espway/espway/schematic/espway.png

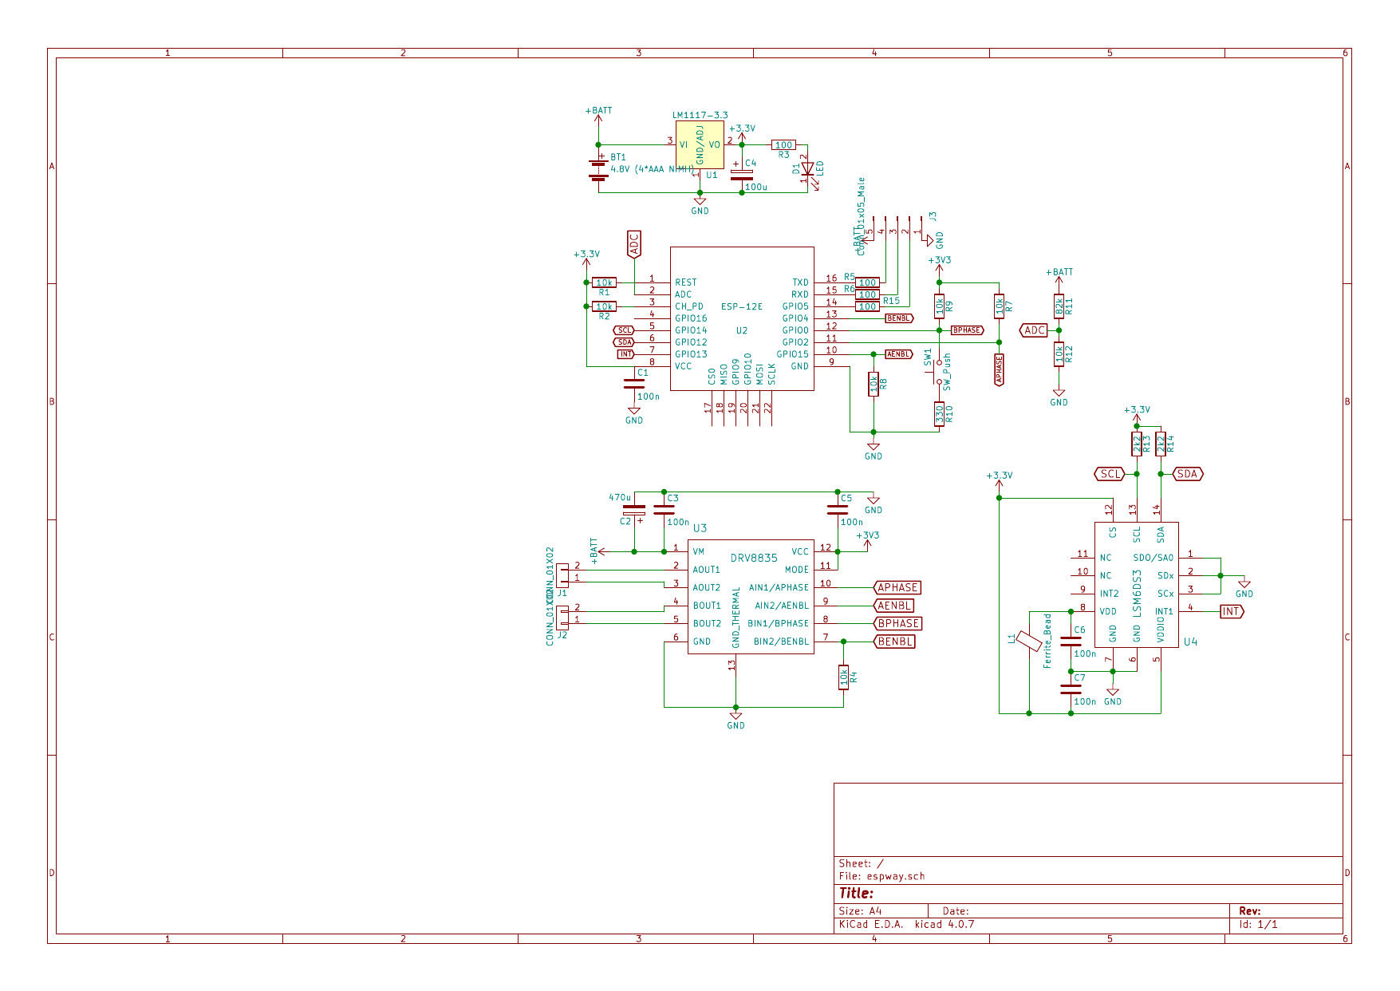
schematic/espway.png
