espway/espway/schematic/espway.pdf

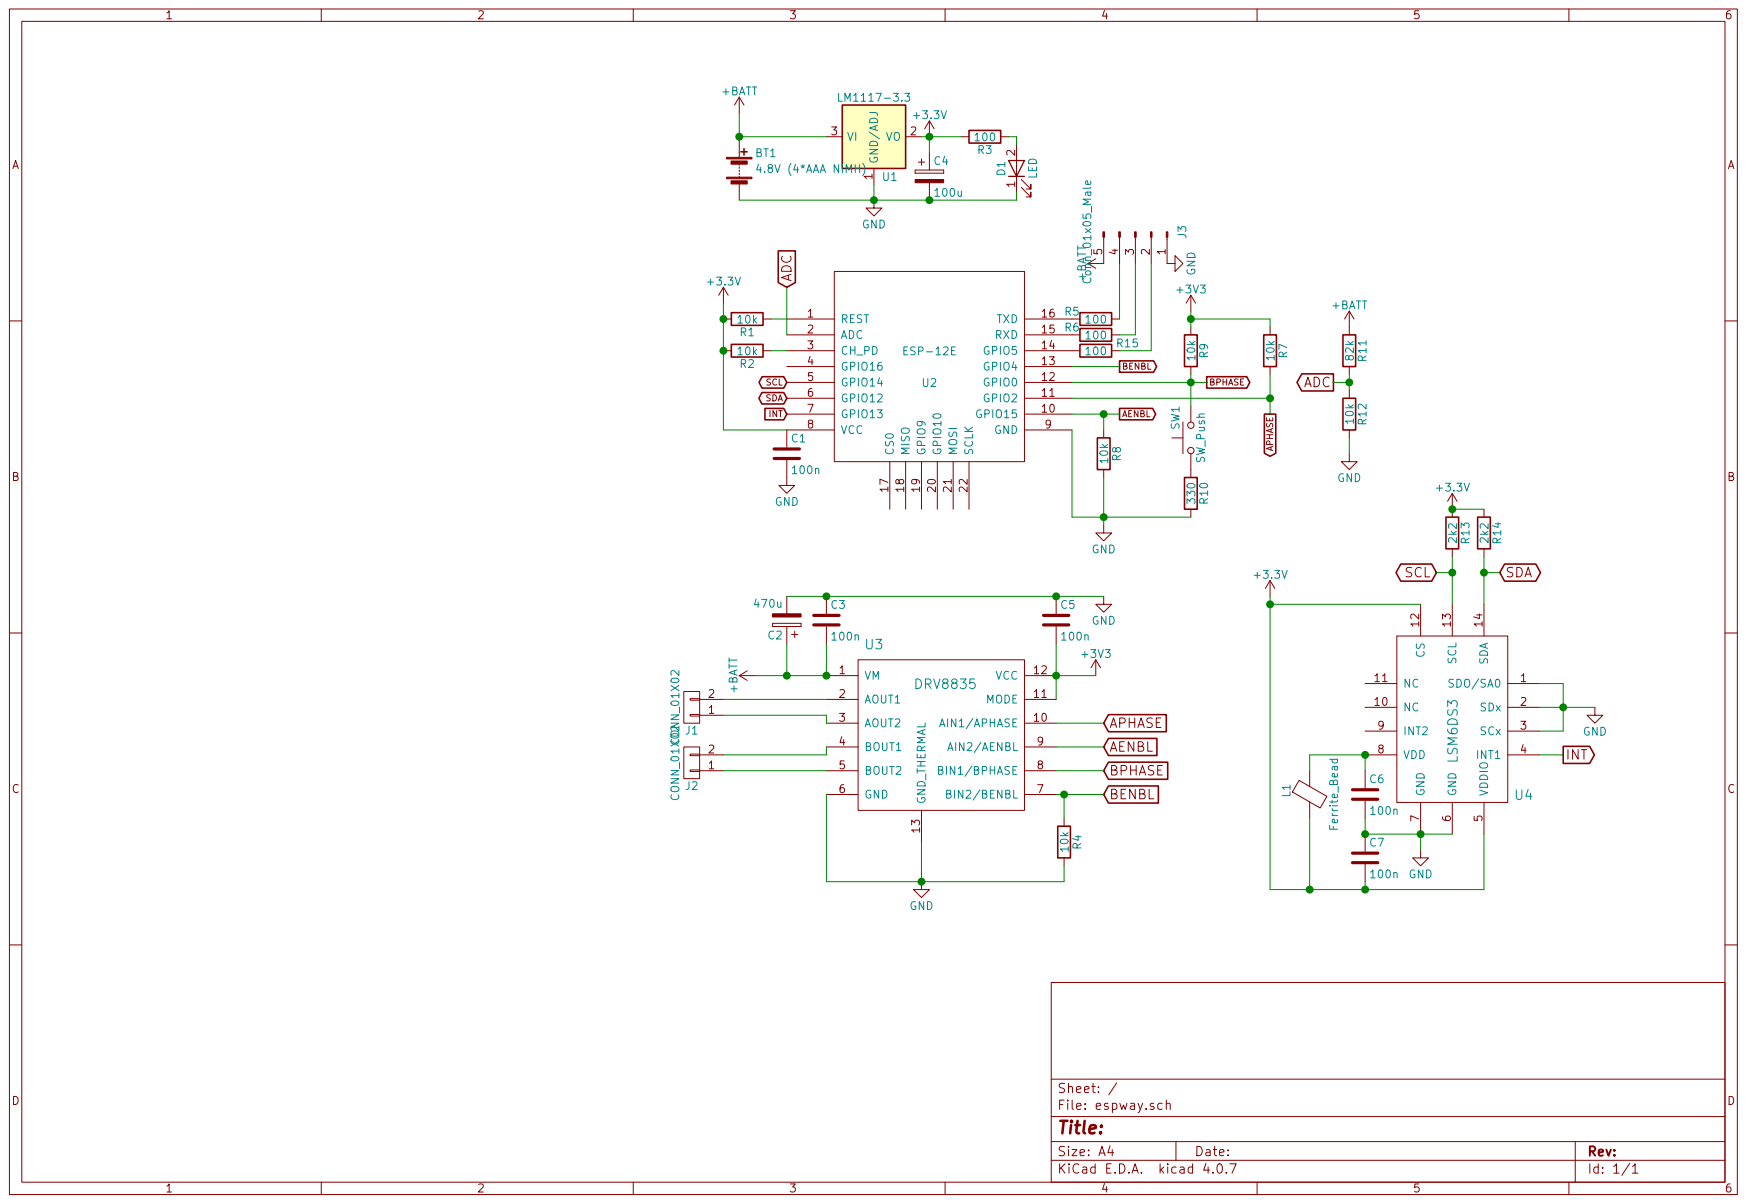
[picture p2: page 1]
