espway/espway/schematic-old/espway.pdf

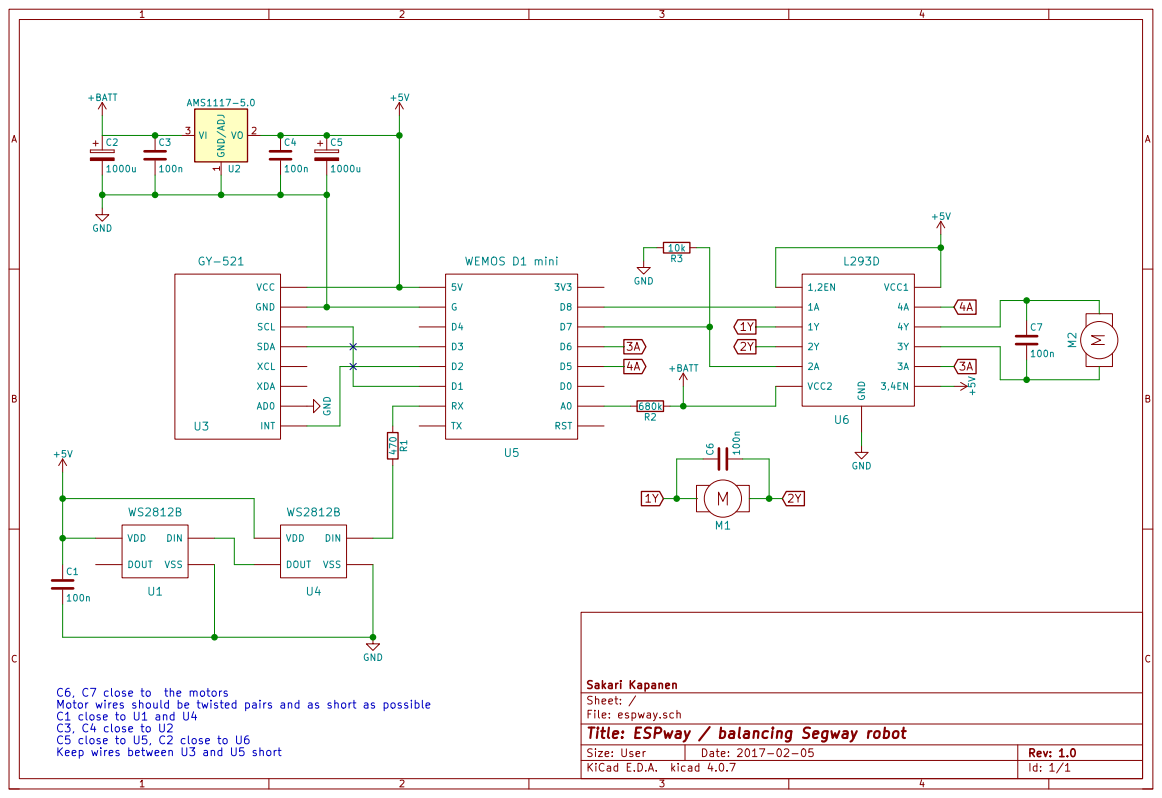
[picture p3: page 1]

File: espway.sch Sheet: / Sakari Kapanen

C6, C7 close to the motors
Motor wires should be twisted pairs and as short as possible
C1 close to U1 and U4
C3, C4 close to U2
C5 close to U5, C2 close to U6
Keep wires between U3 and U5 short

Id: 1/1 Title: ESPway / balancing Segway robot
