espway/espway/src/espway_config.c

/*
 * Firmware for a segway-style robot using ESP8266.
 * Copyright (C) 2017  Sakari Kapanen
 *
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
 * You should have received a copy of the GNU Lesser General Public License
 * along with this program.  If not, see <http://www.gnu.org/licenses/>.
 */

#include <sysparam.h>
#include <stdio.h>

#include "espway.h"

espway_config my_config;

const static espway_config DEFAULT_CONFIG = {
  .pid_coeffs_arr = {
    { FLT_TO_Q16(ANGLE_KP), FLT_TO_Q16(ANGLE_KI), FLT_TO_Q16(ANGLE_KD) },
    { FLT_TO_Q16(VEL_KP), FLT_TO_Q16(VEL_KI), FLT_TO_Q16(VEL_KD) }
  },
  .gyro_offsets = { GYRO_X_OFFSET, GYRO_Y_OFFSET, GYRO_Z_OFFSET }
};

void pretty_print_config(void)
{
  xSemaphoreTake(pid_mutex, portMAX_DELAY);
  printf(
      "\n\nESPway current config:\n\n"
      "#define ANGLE_KP %d\n"
      "#define ANGLE_KI %d\n"
      "#define ANGLE_KD %d\n"
      "#define VEL_KP %d\n"
      "#define VEL_KI %d\n"
      "#define VEL_KD %d\n"
      "#define GYRO_X_OFFSET %d\n"
      "#define GYRO_Y_OFFSET %d\n"
      "#define GYRO_Z_OFFSET %d\n"
      "\n\n",
      my_config.pid_coeffs_arr[ANGLE].p,
      my_config.pid_coeffs_arr[ANGLE].i,
      my_config.pid_coeffs_arr[ANGLE].d,
      my_config.pid_coeffs_arr[VEL].p,
      my_config.pid_coeffs_arr[VEL].i,
      my_config.pid_coeffs_arr[VEL].d,
      my_config.gyro_offsets[0],
      my_config.gyro_offsets[1],
      my_config.gyro_offsets[2]
  );
  xSemaphoreGive(pid_mutex);
}

void load_hardcoded_config(void)
{
  my_config = DEFAULT_CONFIG;
}

void load_config(void)
{
  xSemaphoreTake(pid_mutex, portMAX_DELAY);
  load_hardcoded_config();
  sysparam_get_data_static("ANGLE_PID", (uint8_t *)&my_config.pid_coeffs_arr[ANGLE],
      sizeof(pid_coeffs), NULL, NULL);
  sysparam_get_data_static("VEL_PID", (uint8_t *)&my_config.pid_coeffs_arr[VEL],
      sizeof(pid_coeffs), NULL, NULL);
  sysparam_get_data_static("GYRO_OFFSETS", (uint8_t *)&my_config.gyro_offsets,
      3 * sizeof(int16_t), NULL, NULL);
  xSemaphoreGive(pid_mutex);
}

void apply_config_params(void)
{
  xSemaphoreTake(pid_mutex, portMAX_DELAY);
  pid_initialize(&my_config.pid_coeffs_arr[ANGLE],
      FLT_TO_Q16(SAMPLE_TIME),
      -Q16_ONE, Q16_ONE, false, &pid_settings_arr[ANGLE]);
  pid_initialize(&my_config.pid_coeffs_arr[VEL],
      FLT_TO_Q16(SAMPLE_TIME),
      STABLE_ANGLE - FALL_LIMIT, STABLE_ANGLE + FALL_LIMIT, true,
      &pid_settings_arr[VEL]);
  xSemaphoreGive(pid_mutex);
}

bool save_flash_config(void)
{
  bool success = true;

  xSemaphoreTake(pid_mutex, portMAX_DELAY);
  success = sysparam_set_data("ANGLE_PID", (uint8_t *)&my_config.pid_coeffs_arr[ANGLE],
      sizeof(pid_coeffs), true) == SYSPARAM_OK;
  if (success) success = sysparam_set_data("VEL_PID", (uint8_t *)&my_config.pid_coeffs_arr[VEL], sizeof(pid_coeffs), true) == SYSPARAM_OK;
  xSemaphoreGive(pid_mutex);
  if (success) success = sysparam_set_data("GYRO_OFFSETS", (uint8_t *)&my_config.gyro_offsets, 3 * sizeof(int16_t), true) == SYSPARAM_OK;

  return success;
}

bool clear_flash_config(void)
{
  uint32_t base_addr, num_sectors;
  return sysparam_get_info(&base_addr, &num_sectors) == SYSPARAM_OK &&
    sysparam_create_area(base_addr, num_sectors, true) == SYSPARAM_OK &&
    sysparam_init(base_addr, 0) == SYSPARAM_OK;
}

void update_pid_controller(pid_controller_index idx, q16 p, q16 i, q16 d)
{
  if (idx > 2) return;
  xSemaphoreTake(pid_mutex, portMAX_DELAY);
  pid_coeffs *p_coeffs = &my_config.pid_coeffs_arr[idx];
  p_coeffs->p = p;
  p_coeffs->i = i;
  p_coeffs->d = d;
  pid_update_params(p_coeffs, &pid_settings_arr[idx]);

  xSemaphoreGive(pid_mutex);
}
