espway/espway/src/espway.h

#pragma once

#include <FreeRTOS.h>
#include <semphr.h>
#include <task.h>

#include "lib/pid.h"
#include "lib/imu_hal.h"
#include "lib/vector3d.h"
#include "espway_config.h"

#define SAMPLE_TIME IMU_SAMPLE_TIME

typedef enum {
  STEERING = 0,

  REQ_ORIENTATION = 1,
  RES_ORIENTATION = 2,

  BATTERY = 3,
  BATTERY_CUTOFF = 4,

  REQ_SET_PID_PARAMS = 5,
  RES_SET_PID_PARAMS_ACK = 6,
  REQ_GET_PID_PARAMS = 7,
  RES_PID_PARAMS = 8,

  REQ_SET_GYRO_OFFSETS = 9,
  RES_SET_GYRO_OFFSETS_FAILURE = 10,
  RES_SET_GYRO_OFFSETS_SUCCESS = 11,

  REQ_SAVE_CONFIG = 12,
  RES_SAVE_CONFIG_FAILURE = 13,
  RES_SAVE_CONFIG_SUCCESS = 14,

  REQ_CLEAR_CONFIG = 15,
  RES_CLEAR_CONFIG_FAILURE = 16,
  RES_CLEAR_CONFIG_SUCCESS = 17,

  REQ_LOAD_FLASH_CONFIG = 18,
  RES_LOAD_FLASH_CONFIG_DONE = 19,

  REQ_ENABLE_MOTORS = 20,
  REQ_DISABLE_MOTORS = 21
} ws_msg_t;

typedef struct {
  pid_coeffs pid_coeffs_arr[2];
  int16_t gyro_offsets[3];
} espway_config;

typedef enum {
  ANGLE = 0,
  VEL
} pid_controller_index;

typedef struct {
  q16 sin_pitch;
  q16 sin_roll;
} orientation;

typedef enum { STABILIZING_ORIENTATION, RUNNING, FALLEN, WOUND_UP } state;

extern espway_config my_config;

extern SemaphoreHandle_t pid_mutex;
extern pidsettings pid_settings_arr[2];

void pretty_print_config();
void apply_config_params();
bool save_flash_config();
bool clear_flash_config();
void load_config();
void load_hardcoded_config();
void update_pid_controller(pid_controller_index idx, q16 p, q16 i, q16 d);

void httpd_task(void *pvParameters);

void battery_cutoff();

state get_state();
void set_steering(q16 new_target_speed, q16 new_turning_bias);
orientation get_orientation();

void maze_solver_task(void *pvParameters);
