espway/espway/src/fsdata_custom.c

#include "lwip/apps/fs.h"
#include "lwip/def.h"


#define file_NULL (struct fsdata_file *) NULL


#ifndef FS_FILE_FLAGS_HEADER_INCLUDED
#define FS_FILE_FLAGS_HEADER_INCLUDED 1
#endif
#ifndef FS_FILE_FLAGS_HEADER_PERSISTENT
#define FS_FILE_FLAGS_HEADER_PERSISTENT 0
#endif
/* FSDATA_FILE_ALIGNMENT: 0=off, 1=by variable, 2=by include */
#ifndef FSDATA_FILE_ALIGNMENT
#define FSDATA_FILE_ALIGNMENT 0
#endif
#ifndef FSDATA_ALIGN_PRE
#define FSDATA_ALIGN_PRE
#endif
#ifndef FSDATA_ALIGN_POST
#define FSDATA_ALIGN_POST
#endif
#if FSDATA_FILE_ALIGNMENT==2
#include "fsdata_alignment.h"
#endif
#if FSDATA_FILE_ALIGNMENT==1
static const unsigned int dummy_align__index_bundle_js = 0;
#endif
static const unsigned char FSDATA_ALIGN_PRE data__index_bundle_js[] FSDATA_ALIGN_POST = {
/* /index.bundle.js (17 chars) */
0x2f,0x69,0x6e,0x64,0x65,0x78,0x2e,0x62,0x75,0x6e,0x64,0x6c,0x65,0x2e,0x6a,0x73,
0x00,0x00,0x00,0x00,

/* HTTP header */
/* "HTTP/1.0 200 OK
" (17 bytes) */
0x48,0x54,0x54,0x50,0x2f,0x31,0x2e,0x30,0x20,0x32,0x30,0x30,0x20,0x4f,0x4b,0x0d,
0x0a,
/* "Server: lwIP/2.0.3d (http://savannah.nongnu.org/projects/lwip)
" (64 bytes) */
0x53,0x65,0x72,0x76,0x65,0x72,0x3a,0x20,0x6c,0x77,0x49,0x50,0x2f,0x32,0x2e,0x30,
0x2e,0x33,0x64,0x20,0x28,0x68,0x74,0x74,0x70,0x3a,0x2f,0x2f,0x73,0x61,0x76,0x61,
0x6e,0x6e,0x61,0x68,0x2e,0x6e,0x6f,0x6e,0x67,0x6e,0x75,0x2e,0x6f,0x72,0x67,0x2f,
0x70,0x72,0x6f,0x6a,0x65,0x63,0x74,0x73,0x2f,0x6c,0x77,0x69,0x70,0x29,0x0d,0x0a,

/* "Content-Length: 7773
" (18+ bytes) */
0x43,0x6f,0x6e,0x74,0x65,0x6e,0x74,0x2d,0x4c,0x65,0x6e,0x67,0x74,0x68,0x3a,0x20,
0x37,0x37,0x37,0x33,0x0d,0x0a,
/* "Content-Type: application/javascript

" (40 bytes) */
0x43,0x6f,0x6e,0x74,0x65,0x6e,0x74,0x2d,0x54,0x79,0x70,0x65,0x3a,0x20,0x61,0x70,
0x70,0x6c,0x69,0x63,0x61,0x74,0x69,0x6f,0x6e,0x2f,0x6a,0x61,0x76,0x61,0x73,0x63,
0x72,0x69,0x70,0x74,0x0d,0x0a,0x0d,0x0a,
/* raw file data (7773 bytes) */
0x21,0x66,0x75,0x6e,0x63,0x74,0x69,0x6f,0x6e,0x28,0x65,0x29,0x7b,0x66,0x75,0x6e,
0x63,0x74,0x69,0x6f,0x6e,0x20,0x74,0x28,0x72,0x29,0x7b,0x69,0x66,0x28,0x6e,0x5b,
0x72,0x5d,0x29,0x72,0x65,0x74,0x75,0x72,0x6e,0x20,0x6e,0x5b,0x72,0x5d,0x2e,0x65,
0x78,0x70,0x6f,0x72,0x74,0x73,0x3b,0x76,0x61,0x72,0x20,0x69,0x3d,0x6e,0x5b,0x72,
0x5d,0x3d,0x7b,0x69,0x3a,0x72,0x2c,0x6c,0x3a,0x21,0x31,0x2c,0x65,0x78,0x70,0x6f,
0x72,0x74,0x73,0x3a,0x7b,0x7d,0x7d,0x3b,0x72,0x65,0x74,0x75,0x72,0x6e,0x20,0x65,
0x5b,0x72,0x5d,0x2e,0x63,0x61,0x6c,0x6c,0x28,0x69,0x2e,0x65,0x78,0x70,0x6f,0x72,
0x74,0x73,0x2c,0x69,0x2c,0x69,0x2e,0x65,0x78,0x70,0x6f,0x72,0x74,0x73,0x2c,0x74,
0x29,0x2c,0x69,0x2e,0x6c,0x3d,0x21,0x30,0x2c,0x69,0x2e,0x65,0x78,0x70,0x6f,0x72,
0x74,0x73,0x7d,0x76,0x61,0x72,0x20,0x6e,0x3d,0x7b,0x7d,0x3b,0x72,0x65,0x74,0x75,
0x72,0x6e,0x20,0x74,0x2e,0x6d,0x3d,0x65,0x2c,0x74,0x2e,0x63,0x3d,0x6e,0x2c,0x74,
0x2e,0x69,0x3d,0x66,0x75,0x6e,0x63,0x74,0x69,0x6f,0x6e,0x28,0x65,0x29,0x7b,0x72,
0x65,0x74,0x75,0x72,0x6e,0x20,0x65,0x7d,0x2c,0x74,0x2e,0x64,0x3d,0x66,0x75,0x6e,
0x63,0x74,0x69,0x6f,0x6e,0x28,0x65,0x2c,0x6e,0x2c,0x72,0x29,0x7b,0x74,0x2e,0x6f,
0x28,0x65,0x2c,0x6e,0x29,0x7c,0x7c,0x4f,0x62,0x6a,0x65,0x63,0x74,0x2e,0x64,0x65,
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
0x3e,0x41,0x6e,0x67,0x6c,0x65,0x20,0x50,0x49,0x44,0x3c,0x2f,0x6c,0x61,0x62,0x65,
0x6c,0x3e,0x0a,0x20,0x20,0x20,0x20,0x20,0x20,0x20,0x20,0x20,0x20,0x20,0x20,0x20,
0x20,0x20,0x20,0x3c,0x69,0x6e,0x70,0x75,0x74,0x20,0x74,0x79,0x70,0x65,0x3d,0x27,
0x72,0x61,0x64,0x69,0x6f,0x27,0x20,0x6e,0x61,0x6d,0x65,0x3d,0x27,0x70,0x69,0x64,
0x2d,0x73,0x65,0x6c,0x65,0x63,0x74,0x27,0x20,0x69,0x64,0x3d,0x27,0x76,0x65,0x6c,
0x2d,0x70,0x69,0x64,0x27,0x20,0x76,0x61,0x6c,0x75,0x65,0x3d,0x27,0x76,0x65,0x6c,
0x27,0x20,0x2f,0x3e,0x0a,0x20,0x20,0x20,0x20,0x20,0x20,0x20,0x20,0x20,0x20,0x20,
0x20,0x20,0x20,0x20,0x20,0x3c,0x6c,0x61,0x62,0x65,0x6c,0x20,0x63,0x6c,0x61,0x73,
0x73,0x3d,0x27,0x72,0x61,0x64,0x69,0x6f,0x20,0x72,0x61,0x64,0x69,0x6f,0x2d,0x72,
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



const struct fsdata_file file__index_bundle_js[] = { {
file_NULL,
data__index_bundle_js,
data__index_bundle_js + 20,
sizeof(data__index_bundle_js) - 20,
FS_FILE_FLAGS_HEADER_INCLUDED | FS_FILE_FLAGS_HEADER_PERSISTENT,
}};

const struct fsdata_file file__index_html[] = { {
file__index_bundle_js,
data__index_html,
data__index_html + 12,
sizeof(data__index_html) - 12,
FS_FILE_FLAGS_HEADER_INCLUDED | FS_FILE_FLAGS_HEADER_PERSISTENT,
}};

const struct fsdata_file file__pid_bundle_js[] = { {
file__index_html,
data__pid_bundle_js,
data__pid_bundle_js + 16,
sizeof(data__pid_bundle_js) - 16,
FS_FILE_FLAGS_HEADER_INCLUDED | FS_FILE_FLAGS_HEADER_PERSISTENT,
}};

const struct fsdata_file file__pid_html[] = { {
file__pid_bundle_js,
data__pid_html,
data__pid_html + 12,
sizeof(data__pid_html) - 12,
FS_FILE_FLAGS_HEADER_INCLUDED | FS_FILE_FLAGS_HEADER_PERSISTENT,
}};

#define FS_ROOT file__pid_html
#define FS_NUMFILES 4
