espway/espway/(commit log)

2017-06-21 Start working on i2c and MPU
2017-06-27 Implement battery logging
2017-06-28 Log pitch
2017-06-29 Fix one issue with semaphores
    [espway.cpp]
2017-07-09 Solve a couple of websocket issues
    [espway.cpp]
2017-07-10 Increase main loop priority, fix sysparam mistakes
    [espway.cpp]
2017-07-20 Fix PID and quaternion mutex usage
    [espway.cpp]
2017-07-24 Fixes and cleanups to PWM driver
2017-07-24 Make PWM period configurable
    Fixes to logging in main thread
    [config.h, espway.cpp]
2017-07-25 Switch to espway-devel branch of esp-open-rtos
2017-07-25 Enable CGIs and add shorthands for cube and pid pages
    [espway.cpp]
2017-07-26 Replace captdns with dnsresponder
    [espway.cpp]
2017-07-26 Add handlers for steering and IMU timeouts
2017-07-29 Add new IMU filter
2017-07-29 Remove cube test as it doesn't work with the gravity vector
    [espway.cpp]
2017-07-30 Add Mahony filter and use it by default
    Adjustments and improvements to q16 and vector calculations.
    Other filters will probably be eventually removed.
2017-07-30 Remove old sensor fusion stuff
2017-08-10 Reindent to 2 tabs, add missing GPL headers
    [espway.cpp, espway_config.cpp]
2017-08-15 Remove battery callback
    Use LwIP's TCP core lock instead
2017-09-01 Enable IMU timeout watcher
2017-09-01 Replace the "high PID" implementation with a simpler one
    Just apply full throttle if the robot is about to fall
    [espway.cpp, espway.h, espway_config.cpp]
2017-09-01 Adjust IMU filter params
2017-09-14 Add new schematic, update file structure and README
    [espway.kicad_pcb, espway.sch]
2017-09-14 Add kicad net file, begin associating footprints
    [espway.sch]
2017-09-14 Updates to schematic
    [espway.kicad_pcb, espway.sch]
2017-09-17 Update schematic and PCB layout
    Misses power led and routing
    [espway.kicad_pcb, espway.sch]
2017-09-17 Ignore KiCAD PCB backup files
2017-09-17 Schematic and PCB update
    [espway.kicad_pcb, espway.sch]
2017-09-18 Update schematic and PCB
    [espway.kicad_pcb, espway.sch]
2017-09-19 Update PCB
    [espway.kicad_pcb, espway.sch]
2017-09-23 Add support for DRV8835 motor driver
2017-09-23 Rename imu module to imu_math
2017-09-27 Begin work on IMU HAL
2017-09-28 I2C changes finished
2017-09-28 esp-open-rtos: track espway-devel branch
2017-09-28 Restore motor driver to L293D in config.h
2017-10-01 Disable ooseq queueing and sack
    These seem to cause some latency for reasons currently unknown
2017-10-12 Rename MPU_ADDR -> IMU_ADDR
2017-10-12 Start LSM6DS3 driver, fix config.h mess
    [espway.cpp, espway.h, espway_config.h]
2017-10-12 LSM6DS3 driver working
2017-10-12 A couple of corrections
    [espway.cpp, espway_config.h]
2017-10-14 motors.c bugfixes
2017-10-14 Multiple fixes and config improvements
    [espway.cpp, espway_config.h]
2017-10-15 LSM6DS3: decrease ODR to 833 Hz
    This allows lowering the CPU freq to 80 Hz.
2017-10-15 Plenty of updates to PCB
    * Fix bug where one motor would spin in bootloader
    * Add helpful labels
    * Add another via for V+ near motor driver
    * Larger screw holes
    [espway.kicad_pcb, espway.sch]
2017-10-15 Aesthetic changes to PCB
    [espway.kicad_pcb, espway.sch]
2017-10-16 Ignore plot files in schematic folder
2017-10-16 Config adjustments
    Minor shuffling around in imu_i2c_helper
2017-10-16 Port I2C code to brzo_i2c
2017-10-16 Robustness against I2C errors
    [espway.cpp]
2017-10-16 Decrease I2C pullups to 2k2 (UNTESTED but should work better)
    [espway.kicad_pcb, espway.sch]
2017-10-16 Make motor pins configurable
2017-10-17 Up the CPU and PWM freq
2017-10-18 Tune PWM for 160 MHz CPU freq
2017-10-18 pwm.c cleanup
2017-10-24 Add pwm library license
2017-11-25 PCB: improvements
    Routing simplified
    Use LGA-14 and WSON-12 packages supplied with KiCAD
    diff --git a/schematic-old/espway-rescue.lib b/schematic-old/espway-rescue.lib
    new file mode 100644
    index 0000000..4d5fc14
    --- /dev/null
    +++ b/schematic-old/espway-rescue.lib
    @@ -0,0 +1,25 @@
    +EESchema-LIBRARY Version 2.3
    +#encoding utf-8
    +#
    +# LM1117-5.0-RESCUE-espway
    +#
    +DEF LM1117-5.0-RESCUE-espway U 0 30 Y Y 1 F N
    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
    [espway.kicad_pcb, espway.sch]
2017-11-28 PCB update before rerouting
    [espway.kicad_pcb, espway.sch]
2017-11-29 Initial work on new PCB
    [espway.kicad_pcb, espway.sch]
2017-12-01 Committing before rerouting
    [espway.kicad_pcb]
2017-12-01 An intermediate commit
    [espway.kicad_pcb, espway.sch]
2017-12-01 Clarify modifications in pwm.c
2017-12-03 PCB: stable checkpoint
    [espway.kicad_pcb]
2017-12-03 PCB adjustments
    [espway.kicad_pcb]
2017-12-04 Update esp-open-rtos
    Improvements to I2C communication
2017-12-04 Drop brzo_i2c in favour of esp-open-rtos builtin driver
2017-12-08 Update esp-open-rtos, change I2C IMU API
2017-12-09 Fix PWM license file
2017-12-10 espway_config.cpp: add missing include
    [espway_config.c]
2017-12-10 Prepare for using lwIP httpd diff --git a/Makefile b/Makefile index 6d45249..28c5383 100644 --- a/Makefile +++ b/Makefile @@ -15,34 +15,40 @@ WARNINGS_AS_ERRORS ?= 0
    N_PROCESSES = 5
    -EXTRA_COMPONENTS = extras/dhcpserver extras/httpd extras/mbedtls extras/i2c extras/i2s_dma extras/ws2812_i2s
    +EXTRA_COMPONENTS = extras/dhcpserver extras/i2c extras/i2s_dma extras/ws2812_i2s
    -EXTRA_C_CXX_FLAGS = -DLWIP_HTTPD_CGI=1 -Isrc -DESP_OPEN_RTOS
    +EXTRA_C_CXX_FLAGS = -DLWIP_HTTPD_CGI=1 -DHTTPD_FSDATA_FILE="\"fsdata_custom.c\"" \
    + -Isrc -DESP_OPEN_RTOS
    EXTRA_CXXFLAGS = -std=gnu++11
    # FLAVOR = debug
    # EXTRA_C_CXX_FLAGS += -DLWIP_DEBUG=1 -DHTTPD_DEBUG=LWIP_DBG_ON
    -all: fsdata
    +include esp-open-rtos/c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
2017-12-12 Replace ESP8266_new_pwm with delta-sigma modulator
    [espway.c]
2017-12-13 delta_sigma: add a couple of domain checks
2017-12-20 motors.c: adjust delta-sigma period
2017-12-26 Schematic: change resistor values, break out extra GPIO pin
    [espway.sch]
2017-12-26 PCB: reflect the previous schematic changes
    [espway.kicad_pcb]
2017-12-27 schematic & pcb: pullup fixes etc
    [espway.kicad_pcb, espway.sch]
2017-12-27 Minor PCB track adjustments
    [espway.kicad_pcb, espway.sch]
2018-01-01 Final changes to schematic
    [espway.kicad_pcb]
2018-01-15 Add IMU interrupt pin definition, document more parameters
2018-01-15 Updates to README and schematics
    [espway.sch]
2018-01-19 Fix some mistakes preventing compilation
    [espway.c]
2018-01-23 Adaptation for new PCB
2018-01-23 Minor component value updates
    [espway.kicad_pcb, espway.sch]
2018-01-23 Add notes about new schematic
2018-01-23 Saner battery scaling
2018-02-01 Add foundations for maze solver
    Revert the GPIO handler change - it is already handled by esp-open-rtos
    [espway.c, espway.h, espway_config.h]
2018-02-03 ultrasonic: increase reliability, remove some race conditions
2018-02-04 Add samplebuffer implementation
2018-02-04 Allow synchronized access to steering from outside
2018-02-04 Maze solver: use samplebuffer to smooth out values
2018-02-05 delta_sigma: use interrupt safe critical section entry/exit
2018-02-25 Implement probing for ultrasonic sensors and initiate maze solving
2018-02-25 samplebuffer: add reset function
2018-02-25 Fixes to wall follower logic
    [espway_maze_solver.cpp]
2018-02-25 Simplify wall follower control flow
2018-02-28 ultrasonic: remove unnecessary delay
2018-02-28 Maze solver: logic fixes
    [espway_maze_solver.cpp]
2018-03-01 ultrasonic: perform triggering inside critical section
    Decrease trigger pulse width
2018-03-02 Better tunings and minor fixes
    [espway_maze_solver.cpp]
2021-11-09 Update README.md
    https://forum.kicad.info/t/warning-avoid-all-links-to-kicad-pcb-org-use-kicad-org/31521
2021-11-11 README: update a couple of links
